Siddhartha006/Flood-Monitoring-and-Early-Warning-System/README.md

# Flood-Monitoring-and-Early-Warning-System
IoT flood monitoring prototype using ESP8266, ultrasonic sensing, and ThingsBoard.
